SpaceTeam/STS1_BATTERY_TEST_SETUP/sims/discharge.asc

C3: cap; 100n
M2: nmos; Si7868DP
R1: res; 10k
R3: res; .002
R4: res; 680
V1: voltage; 3.2
V3: signal; PULSE(0 3 0 0 0 {To} 1u)
Named nets: 0
.tran 1.5m
.step param To 100n 700n 20n
