SpaceTeam/STS1_BATTERY_TEST_SETUP/sims/mosfetDcSweep.asc

M2: nmos; Si7868DP
R2: res; 1
R3: res; .002
V1: voltage; 3.2
V2: voltage; 3
Named nets: 0
.dc V2 0 5
