SpaceTeam/STS1_BATTERY_TEST_SETUP/pcbs/hat/BatteryTester.kicad_pcb

## KiCad design pcbs/hat/BatteryTester.kicad_pcb (2022-11-05)

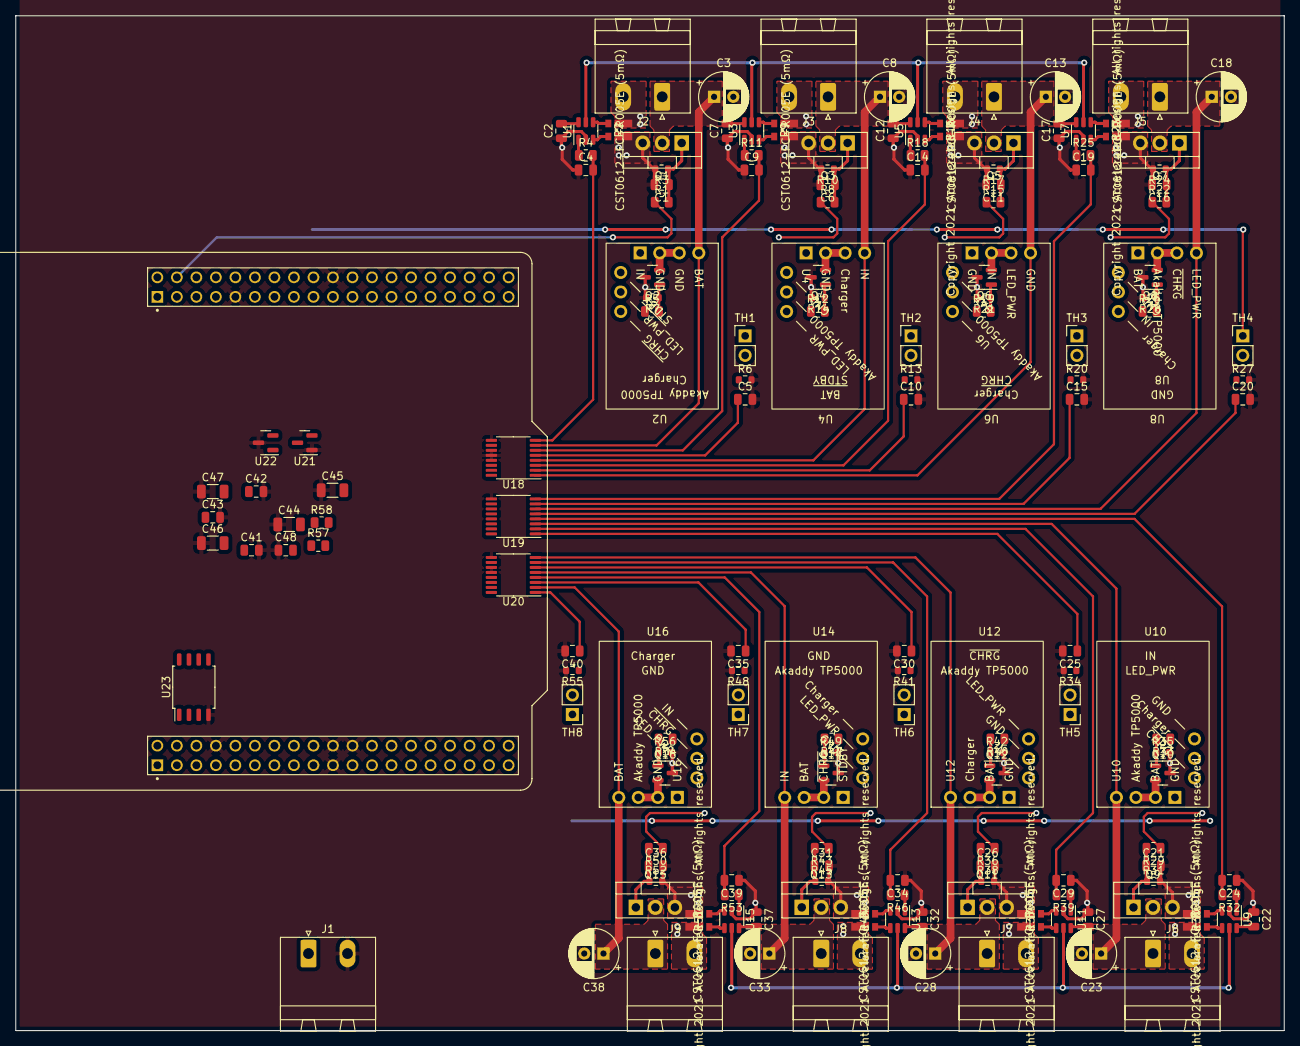
[picture p1: board BatteryTester.kicad_pcb from above]

Board: 4 copper layers, 165.1 x 132.1 mm, 162 parts (0 on the bottom side), 118 nets.

Parts:
C1, C6, C11, C16, C21, C26, C31, C36: 220n; C_0805_2012Metric
C2, C7, C12, C17, C22, C27, C32, C37, C41, C42, C43, C48: 100n; C_0805_2012Metric
C3, C8, C13, C18, C23, C28, C33, C38: optional; CP_Radial_D6.3mm_P2.50mm
C4, C9, C14, C19, C24, C29, C34, C39: 15u; C_0805_2012Metric
C5, C10, C15, C20, C25, C30, C35, C40: 1u; C_0805_2012Metric
C44, C45: 47u; C_1206_3216Metric
C46, C47: 22u; C_1206_3216Metric
J1: Supply Connector; PhoenixContact_MSTBA_2,5_2-G-5,08_1x02_P5.08mm_Horizontal
J2, J3, J4, J5, J6, J7, J8, J9: Battery Connector; PhoenixContact_MSTBA_2,5_2-G-5,08_1x02_P5.08mm_Horizontal
Q1, Q3, Q5, Q7, Q9, Q11, Q13, Q15: DMT6009LCT; TO-220-3_Vertical
Q2, Q4, Q6, Q8, Q10, Q12, Q14, Q16: AO3414; SOT-23
R1, R5, R8, R12, R15, R19, R22, R26, R29, R33, R36, R40, R43, R47, R50, R54: 680; R_0805_2012Metric
R2, R9, R16, R23, R30, R37, R44, R51: CST0612-FC-R005E (5mΩ); CST0612-FC-R002E
R3, R6, R7, R10, R13, R14, R17, R20, R21, R24, R27, R28, R31, R34, R35, R38, R41, R42, R45, R48, R49, R52, R55, R56: 10k; R_0603_1608Metric
R4, R11, R18, R25, R32, R39, R46, R53: 1k; R_0805_2012Metric
R57, R58: 100; R_0805_2012Metric
TH1, TH2, TH3, TH4, TH5, TH6, TH7, TH8: Thermistor_NTC_10k; PinHeader_1x02_P2.54mm_Vertical
U1, U3, U5, U7, U9, U11, U13, U15: INA181A2IDBVR; SOT-23-6
U2, U4, U6, U8, U10, U12, U14, U16: TP5000_Breakout_Akaddy
U17: NUCLEO-F401RE; ST_Morpho_Connector_64
U18, U19, U20: ADS7828; TSSOP-16_4.4x5mm_P0.65mm
U21: AP2138N-2.5TRG1; SOT-23
U22: LM3480-5.0; SOT-23
U23: SST25VF016B; SOIC-8_5.275x5.275mm_P1.27mm

Connections:
+3V3: C48.2, U23.3 (~WP), U23.7 (~HOLD), U23.8 (VDD)
+5V: C2.2, C7.2, C12.2, C17.2, C22.2, C27.2, C32.2, C37.2, C41.1, C42.1, C43.1, R57.1, TH1.1, TH2.1, TH3.1, TH4.1, TH5.1, TH6.1, TH7.1, TH8.1, U1.6 (V+), U3.6 (V+), U5.6 (V+), U7.6 (V+), U9.6 (V+), U11.6 (V+), U13.6 (V+), U15.6 (V+), U17.CN7_16 (+3V3_S1), U18.16 (VDD), U19.12 (A0), U19.16 (VDD), U20.13 (A1), U20.16 (VDD)
/Board/ADC_SCL: U17.CN10_3 (PB8), U18.14 (SCL), U19.14 (SCL), U20.14 (SCL)
/Board/ADC_SDA: U17.CN10_5 (PB9), U18.15 (SDA), U19.15 (SDA), U20.15 (SDA)
/Board/MEM_MISO: U17.CN7_2 (PC11), U23.2 (SO)
/Board/MEM_MOSI: U17.CN7_3 (PC12), U23.5 (SI)
/Board/MEM_SCK: U17.CN7_1 (PC10), U23.6 (SCK)
/Board/~MEM_CE: U17.CN7_4 (PD2), U23.1 (~CE)
/Converters/ADC_Ref: C47.2, U18.10 (REF), U19.10 (REF), U20.10 (REF), U22.1 (VO)
/SENSOR_10: C3.1, J2.1, Q1.2 (D), U2.3 (OUT+), U18.7 (CH6)
/SENSOR_11: C4.2, R4.2, U18.8 (CH7)
/SENSOR_12: C5.1, R6.1, TH1.2, U18.5 (CH4)
/SENSOR_13: U2.11 (~STDBY), U17.CN10_2 (PC8)
/SENSOR_20: C8.1, J3.1, Q3.2 (D), U4.3 (OUT+), U18.4 (CH3)
/SENSOR_21: C9.2, R11.2, U18.6 (CH5)
/SENSOR_22: C10.1, R13.1, TH2.2, U18.2 (CH1)
/SENSOR_23: U4.11 (~STDBY), U17.CN10_6 (PC5)
/SENSOR_30: C13.1, J4.1, Q5.2 (D), U6.3 (OUT+), U18.1 (CH0)
/SENSOR_31: C14.2, R18.2, U18.3 (CH2)
/SENSOR_32: C15.1, R20.1, TH3.2, U19.7 (CH6)
/SENSOR_33: U6.11 (~STDBY), U17.CN10_34 (PC4)
/SENSOR_40: C18.1, J5.1, Q7.2 (D), U8.3 (OUT+), U19.6 (CH5)
/SENSOR_41: C19.2, R25.2, U19.8 (CH7)
/SENSOR_42: C20.1, R27.1, TH4.2, U19.5 (CH4)
/SENSOR_43: U8.11 (~STDBY), U17.CN10_29 (PB5)
/SENSOR_50: C23.1, J6.1, Q9.2 (D), U10.3 (OUT+), U19.3 (CH2)
/SENSOR_51: C24.2, R32.2, U19.4 (CH3)
/SENSOR_52: C25.1, R34.1, TH5.2, U19.1 (CH0)
/SENSOR_53: U10.11 (~STDBY), U17.CN10_25 (PB10)
/SENSOR_60: C28.1, J7.1, Q11.2 (D), U12.3 (OUT+), U20.8 (CH7)
/SENSOR_61: C29.2, R39.2, U19.2 (CH1)
/SENSOR_62: C30.1, R41.1, TH6.2, U20.6 (CH5)
/SENSOR_63: U12.11 (~STDBY), U17.CN10_21 (PA9)
/SENSOR_70: C33.1, J8.1, Q13.2 (D), U14.3 (OUT+), U20.5 (CH4)
/SENSOR_71: C34.2, R46.2, U20.7 (CH6)
/SENSOR_72: C35.1, R48.1, TH7.2, U20.3 (CH2)
/SENSOR_73: U14.11 (~STDBY), U17.CN7_36 (PC1/PB9)
/SENSOR_80: C38.1, J9.1, Q15.2 (D), U16.3 (OUT+), U20.2 (CH1)
/SENSOR_81: C39.2, R53.2, U20.4 (CH3)
/SENSOR_82: C40.1, R55.1, TH8.2, U20.1 (CH0)
/SENSOR_83: U16.11 (~STDBY), U17.CN7_37 (PC3)
/SIGNAL_10: R5.1, U17.CN10_12 (PA12)
/SIGNAL_11: R1.1, U17.CN10_4 (PC6)
/SIGNAL_20: R12.1, U17.CN10_16 (PB12)
/SIGNAL_21: R8.1, U17.CN10_24 (PB1)
/SIGNAL_30: R19.1, U17.CN10_33 (PA10)
/SIGNAL_31: R15.1, U17.CN10_30 (PB13)
/SIGNAL_40: R26.1, U17.CN10_28 (PB14)
/SIGNAL_41: R22.1, U17.CN10_27 (PB4)
/SIGNAL_50: R33.1, U17.CN10_23 (PA8)
/SIGNAL_51: R29.1, U17.CN10_22 (PB2)
/SIGNAL_60: R40.1, U17.CN10_19 (PC7)
/SIGNAL_61: R36.1, U17.CN10_17 (PB6)
/SIGNAL_70: R47.1, U17.CN7_38 (PC0/PB8)
/SIGNAL_71: R43.1, U17.CN7_30 (PA1)
/SIGNAL_80: R54.1, U17.CN7_35 (PC2)
/SIGNAL_81: R50.1, U17.CN7_28 (PA0)
/test-battery-1/GNDBAT: J2.2, R2.4
/test-battery-2/GNDBAT: J3.2, R9.4
/test-battery-3/GNDBAT: J4.2, R16.4
/test-battery-4/GNDBAT: J5.2, R23.4
/test-battery-5/GNDBAT: J6.2, R30.4
/test-battery-6/GNDBAT: J7.2, R37.4
/test-battery-7/GNDBAT: J8.2, R44.4
/test-battery-8/GNDBAT: J9.2, R51.4
GND: C1.2, C2.1, C3.2, C4.1, C5.2, C6.2, C7.1, C8.2, C9.1, C10.2, C11.2, C12.1, C13.2, C14.1, C15.2, C16.2, C17.1, C18.2, C19.1, C20.2, C21.2, C22.1, C23.2, C24.1, C25.2, C26.2, C27.1, C28.2, C29.1, C30.2, C31.2, C32.1, C33.2, C34.1, C35.2, C36.2, C37.1, C38.2, C39.1, C40.2, C41.2, C42.2, C43.2, C44.1, C45.1, C46.1, C47.1, C48.1, J1.2, Q1.3 (S), Q2.3 (S), Q3.3 (S), Q4.3 (S), Q5.3 (S), Q6.3 (S), Q7.3 (S), Q8.3 (S), Q9.3 (S), Q10.3 (S), Q11.3 (S), Q12.3 (S), Q13.3 (S), Q14.3 (S), Q15.3 (S), Q16.3 (S), R2.1, R3.2, R6.2, R7.2, R9.1, R10.2, R13.2, R14.2, R16.1, R17.2, R20.2, R21.2, R23.1, R24.2, R27.2, R28.2, R30.1, R31.2, R34.2, R35.2, R37.1, R38.2, R41.2, R42.2, R44.1, R45.2, R48.2, R49.2, R51.1, R52.2, R55.2, R56.2, U1.2 (GND), U3.2 (GND), U5.2 (GND), U7.2 (GND), U9.2 (GND), U11.2 (GND), U13.2 (GND), U15.2 (GND), U17.CN7_8 (GND_S1), U17.CN7_19 (GND_S1), U17.CN7_20 (GND_S1), U17.CN7_22 (GND_S1), U17.CN10_9 (GND_S2), U17.CN10_20 (GND_S2), U18.9 (GND), U18.11 (COM), U18.12 (A0), U18.13 (A1), U19.9 (GND), U19.11 (COM), U19.13 (A1), U20.9 (GND), U20.11 (COM), U20.12 (A0), U21.1 (GND), U22.3 (GND), U23.4 (VSS)
unnamed: C1.1, Q1.1 (G), R1.2, R3.1
unnamed: C6.1, Q3.1 (G), R8.2, R10.1
unnamed: C11.1, Q5.1 (G), R15.2, R17.1
unnamed: C16.1, Q7.1 (G), R22.2, R24.1
unnamed: C21.1, Q9.1 (G), R29.2, R31.1
unnamed: C26.1, Q11.1 (G), R36.2, R38.1
unnamed: C31.1, Q13.1 (G), R43.2, R45.1
unnamed: C36.1, Q15.1 (G), R50.2, R52.1
unnamed: C44.2, R57.2, U21.3 (VI)
unnamed: C45.2, R58.2, U22.2 (VI)
unnamed: Q2.1 (G), R5.2, R7.1
unnamed: Q2.2 (D), U2.2 (GND), U2.4 (GND)
unnamed: Q4.1 (G), R12.2, R14.1
unnamed: Q4.2 (D), U4.2 (GND), U4.4 (GND)
unnamed: Q6.1 (G), R19.2, R21.1
unnamed: Q6.2 (D), U6.2 (GND), U6.4 (GND)
unnamed: Q8.1 (G), R26.2, R28.1
unnamed: Q8.2 (D), U8.2 (GND), U8.4 (GND)
unnamed: Q10.1 (G), R33.2, R35.1
unnamed: Q10.2 (D), U10.2 (GND), U10.4 (GND)
unnamed: Q12.1 (G), R40.2, R42.1
unnamed: Q12.2 (D), U12.2 (GND), U12.4 (GND)
unnamed: Q14.1 (G), R47.2, R49.1
unnamed: Q14.2 (D), U14.2 (GND), U14.4 (GND)
unnamed: Q16.1 (G), R54.2, R56.1
unnamed: Q16.2 (D), U16.2 (GND), U16.4 (GND)
unnamed: R2.2, U1.3 (+)
unnamed: R2.3, U1.4 (-)
unnamed: R4.1, U1.1
unnamed: R9.2, U3.3 (+)
unnamed: R9.3, U3.4 (-)
unnamed: R11.1, U3.1
unnamed: R16.2, U5.3 (+)
unnamed: R16.3, U5.4 (-)
unnamed: R18.1, U5.1
unnamed: R23.2, U7.3 (+)
unnamed: R23.3, U7.4 (-)
unnamed: R25.1, U7.1
unnamed: R30.2, U9.3 (+)
unnamed: R30.3, U9.4 (-)
unnamed: R32.1, U9.1
unnamed: R37.2, U11.3 (+)
unnamed: R37.3, U11.4 (-)
unnamed: R39.1, U11.1
unnamed: R44.2, U13.3 (+)
unnamed: R44.3, U13.4 (-)
unnamed: R46.1, U13.1
unnamed: R51.2, U15.3 (+)
unnamed: R51.3, U15.4 (-)
unnamed: R53.1, U15.1
VCC: J1.1, R58.1, U2.1 (IN+), U4.1 (IN+), U6.1 (IN+), U8.1 (IN+), U10.1 (IN+), U12.1 (IN+), U14.1 (IN+), U16.1 (IN+), U17.CN7_24 (VIN_S1)
Vref_I_SENS: C46.2, U1.5 (REF), U3.5 (REF), U5.5 (REF), U7.5 (REF), U9.5 (REF), U11.5 (REF), U13.5 (REF), U15.5 (REF), U21.2 (VO)
