SpaceTeam/STS1_BATTERY_TEST_SETUP/(threads)

Thread 1 (2023-03-02):

TODO

rol1510, 2023-03-02:
Board.kicad_sch
 - SENSOR_XX aund SIGNAL_XX gehen auf den gleichen Bus. Funktioniert das?
 - U17C -> VIN, +5V +3V3, Reset nicht verbunden. Warum?
 - U17A -> RESET_S1 nicht verbunden. Warum?
 - Wie wird Nucleo geflasht?
   - Via USB-Kabel

Converters.kicad_sch
 - Ist ADC_Ref gleichzeitig VDD für ADCs? Falls ja, bitte über zwei separate LDOs machen.
 - Ein Kondensator nahe bei den ADCs am REF pin schadet vermutlich auch nicht.

Test-battery.kicad_sch
 - Mit der Current Sensor schaltung können wir nur den Ladestrom messen. Richtig? Bei einem Entladestrom, würde der OPV nur 0V ausgeben?
 - Entladen wird ja über einen mosfet über PWM. Baust du dann im code eine Regelschleife ein, die den duty cycle der PWM steuert?
   - Wäre so geplant
