SpaceTeam/STS1_BATTERY_TEST_SETUP/software/firmware/src/msg_types.rs

use heapless::String;
use serde::{Deserialize, Serialize};

#[derive(Serialize, Deserialize, Debug, PartialEq)]
pub enum MsgTypes {
    Msg(String<128>),
    Ping(u16),
    Test1(u32),
    Test2(f32, u8),

    SampleAdc(u8),
    SampleAdcResult(u16),
}
