SpaceTeam/STS1_BATTERY_TEST_SETUP/software/client/src/ui.rs

use crossterm::{
    cursor::{RestorePosition, SavePosition},
    event::{self, DisableMouseCapture, EnableMouseCapture, Event, KeyCode},
    execute,
    terminal::{disable_raw_mode, enable_raw_mode, EnterAlternateScreen, LeaveAlternateScreen},
};
use easy_min_max::max;
use std::{error::Error, io, time::Duration};
use tui::{
    backend::{Backend, CrosstermBackend},
    layout::{Constraint, Direction, Layout},
    style::{Color, Modifier, Style},
    text::{Span, Spans, Text},
    widgets::{Block, Borders, List, ListItem, Paragraph},
    Frame, Terminal,
};
use unicode_width::UnicodeWidthStr;

enum InputMode {
    Normal,
    Editing,
}

pub enum AppEvent {
    Quit,
    None,
    Input(String),
    SendPing(u16),
    SampleAdc(u8),
}

pub struct App {
    input: String,
    input_mode: InputMode,
    pub messages: Vec<String>,
}

impl Default for App {
    fn default() -> App {
        App {
            input: String::new(),
            input_mode: InputMode::Normal,
            messages: Vec::new(),
        }
    }
}

pub type TerminalStdout = Terminal<CrosstermBackend<io::Stdout>>;

pub fn setup() -> Result<TerminalStdout, Box<dyn Error>> {
    enable_raw_mode()?;
    let mut stdout = io::stdout();
    execute!(
        stdout,
        EnterAlternateScreen,
        EnableMouseCapture,
        SavePosition
    )?;
    let backend = CrosstermBackend::new(stdout);
    let terminal = Terminal::new(backend)?;
    Ok(terminal)
}

pub fn restore(terminal: &mut TerminalStdout) -> Result<(), Box<dyn Error>> {
    disable_raw_mode()?;
    execute!(
        terminal.backend_mut(),
        LeaveAlternateScreen,
        DisableMouseCapture,
        RestorePosition,
    )?;
    terminal.show_cursor()?;
    Ok(())
}

pub fn update<B: Backend>(terminal: &mut Terminal<B>, app: &mut App) -> AppEvent {
    terminal.draw(|f| ui(f, &app)).unwrap();

    // update should not block the main loop.
    if event::poll(Duration::from_millis(16)).unwrap() == false {
        return AppEvent::None;
    }

    if let Event::Key(key) = event::read().unwrap() {
        match app.input_mode {
            InputMode::Normal => match key.code {
                KeyCode::Char('e') => {
                    app.input_mode = InputMode::Editing;
                }
                KeyCode::Char('q') => return AppEvent::Quit,
                _ => {}
            },
            InputMode::Editing => match key.code {
                KeyCode::Enter => {
                    let value = app.input.drain(..).collect();

                    match crate::input_parser::try_parse(&value) {
                        Some(event) => return event,
                        None => {
                            return AppEvent::Input(value);
                        }
                    }
                }
                KeyCode::Char(c) => {
                    app.input.push(c);
                }
                KeyCode::Backspace => {
                    app.input.pop();
                }
                KeyCode::Esc => {
                    app.input_mode = InputMode::Normal;
                }
                _ => {}
            },
        }
    }

    return AppEvent::None;
}

fn ui<B: Backend>(f: &mut Frame<B>, app: &App) {
    let chunks = Layout::default()
        .direction(Direction::Vertical)
        .margin(2)
        .constraints(
            [
                Constraint::Length(1),
                Constraint::Length(3),
                Constraint::Min(1),
            ]
            .as_ref(),
        )
        .split(f.size());

    let (msg, style) = match app.input_mode {
        InputMode::Normal => (
            vec![
                Span::raw("Press "),
                Span::styled("q", Style::default().add_modifier(Modifier::BOLD)),
                Span::raw(" to exit, "),
                Span::styled("e", Style::default().add_modifier(Modifier::BOLD)),
                Span::raw(" to start editing."),
            ],
            Style::default().add_modifier(Modifier::RAPID_BLINK),
        ),
        InputMode::Editing => (
            vec![
                Span::raw("Press "),
                Span::styled("Esc", Style::default().add_modifier(Modifier::BOLD)),
                Span::raw(" to stop editing, "),
                Span::styled("Enter", Style::default().add_modifier(Modifier::BOLD)),
                Span::raw(" to record the message"),
            ],
            Style::default(),
        ),
    };
    let mut text = Text::from(Spans::from(msg));
    text.patch_style(style);
    let help_message = Paragraph::new(text);
    f.render_widget(help_message, chunks[0]);

    let input = Paragraph::new(app.input.as_ref())
        .style(match app.input_mode {
            InputMode::Normal => Style::default(),
            InputMode::Editing => Style::default().fg(Color::Yellow),
        })
        .block(Block::default().borders(Borders::ALL).title("Input"));
    f.render_widget(input, chunks[1]);
    match app.input_mode {
        InputMode::Normal =>
            // Hide the cursor. `Frame` does this by default, so we don't need to do anything here
            {}

        InputMode::Editing => {
            // Make the cursor visible and ask tui-rs to put it at the specified coordinates after rendering
            f.set_cursor(
                // Put cursor past the end of the input text
                chunks[1].x + app.input.width() as u16 + 1,
                // Move one line down, from the border to the input line
                chunks[1].y + 1,
            )
        }
    }

    let height = chunks[2].height as i32;
    let to_skip = max!(0, app.messages.len() as i32 - height) as usize;

    let messages: Vec<ListItem> = app
        .messages
        .iter()
        .enumerate()
        .skip(to_skip)
        .map(|(i, m)| {
            let content = vec![Spans::from(Span::raw(format!("{}: {}", i, m)))];
            ListItem::new(content)
        })
        .collect();
    let messages =
        List::new(messages).block(Block::default().borders(Borders::ALL).title("Messages"));
    f.render_widget(messages, chunks[2]);
}
