SpaceTeam/STS1_BATTERY_TEST_SETUP/(commit log)

2022-08-12 add kicad libraries
    [BatteryTester.kicad_pcb, BatteryTester.kicad_sch]
2022-08-12 remove kicad backups
2022-08-15 setup hierarchy and add Nucleo footprint
    [BatteryTester.kicad_pcb, BatteryTester.kicad_sch, board.kicad_sch, test-battery.kicad_sch]
2022-08-15 fix symbol and footprint libraries
    [BatteryTester.kicad_pcb, BatteryTester.kicad_sch, board.kicad_sch, test-battery.kicad_sch]
2022-08-15 add ADCs
    [BatteryTester.kicad_pcb, BatteryTester.kicad_sch, board.kicad_sch, converters.kicad_sch, test-battery.kicad_sch]
2022-08-20 select parts for current and temperature sensors
    [BatteryTester.kicad_pcb, BatteryTester.kicad_sch, converters.kicad_sch, test-battery.kicad_sch]
2022-08-20 work on charging circuit
    [BatteryTester.kicad_pcb, BatteryTester.kicad_sch, board.kicad_sch, test-battery.kicad_sch]
2022-09-04 more work on charging circuit
    [BatteryTester.kicad_pcb, BatteryTester.kicad_sch, board.kicad_sch, converters.kicad_sch, test-battery.kicad_sch]
2022-09-04 fix the current sensor
    [BatteryTester.kicad_pcb, BatteryTester.kicad_sch, converters.kicad_sch, test-battery.kicad_sch]
2022-09-05 change ADCs and connect all Sensors and Signals
    [BatteryTester.kicad_pcb, BatteryTester.kicad_sch, board.kicad_sch, converters.kicad_sch]
2022-09-05 add vref for adc's
    [BatteryTester.kicad_pcb, BatteryTester.kicad_sch, converters.kicad_sch]
2022-09-18 few little change
    [BatteryTester.kicad_pcb, BatteryTester.kicad_sch, board.kicad_sch, converters.kicad_sch, test-battery.kicad_sch]
2022-09-18 add memory + check footprints
    [BatteryTester.kicad_pcb, BatteryTester.kicad_sch, board.kicad_sch, converters.kicad_sch, test-battery.kicad_sch]
2022-09-19 beginning of the layout
    [BatteryTester.kicad_pcb, BatteryTester.kicad_sch, converters.kicad_sch, test-battery.kicad_sch]
2022-10-16 finish the pin assignment
    [BatteryTester.kicad_pcb, BatteryTester.kicad_sch, board.kicad_sch]
2022-10-16 reassign adc's
    [BatteryTester.kicad_pcb, board.kicad_sch, converters.kicad_sch, test-battery.kicad_sch]
2022-10-17 pcb layout progress
    [BatteryTester.kicad_pcb, BatteryTester.kicad_sch, board.kicad_sch, converters.kicad_sch]
2022-11-21 remove build warning from board
2022-12-06 test the transmission protocol on the board
2022-12-07 send msg from board + setup panic handler
2022-12-08 read adc
2022-12-19 basic client ui + handle transmission errors
    [input_parser.rs, lib.rs, main.rs, serial_manager.rs]
2022-12-20 move panic handler to own file + fix warnings
    [main.rs, panic_handler.rs]
2022-12-20 sample the adc
