SpaceTeam/STS1_BATTERY_TEST_SETUP/(notices)

Notices in the files:
parts and their libraries:
Copyright 2021 Accelerated Designs. All rights reserved.
